sbasami/UAV2024/001_3Dデータ/README.md

# 3Dデータ
* Frame_Prop_4 v5: ロッドフレームの3Dデータ
* Frame_UAV2024 v2: 本体フレームの3Dデータ
