sbasami/UAV2024/000_回路図データ/README.md

# 回路図データ
* BMI088_ver2: BMI088モジュール基板のKiCad回路データ
* UAV2021_ver3: フライトコントローラ基板のKiCad回路データ
* UAV2021_ver3_panelizing: BMI088_ver2とUAV2021_ver3を面付けしたPCBデータとガーバーデータ(このデータを使って基板製造業者に発注)
