sbasami/UAV2024/000_回路図データ/BMI088_ver2/BMI088_2021.xlsx

Designator | Manufacturer Part Number or Seeed SKU | Qty | Link
C1,C2 | GRM155R71C104KA88D | 2 | https://www.digikey.jp/product-detail/ja/murata-electronics/GRM155R71C104KA88D/490-3261-1-ND/702802
IC1 | BMI088 | 1 | https://www.digikey.jp/product-detail/ja/bosch-sensortec/BMI088/828-1082-1-ND/8634942
