sbasami/UAV2024/000_回路図データ/BMI088_ver2/BMI088.step

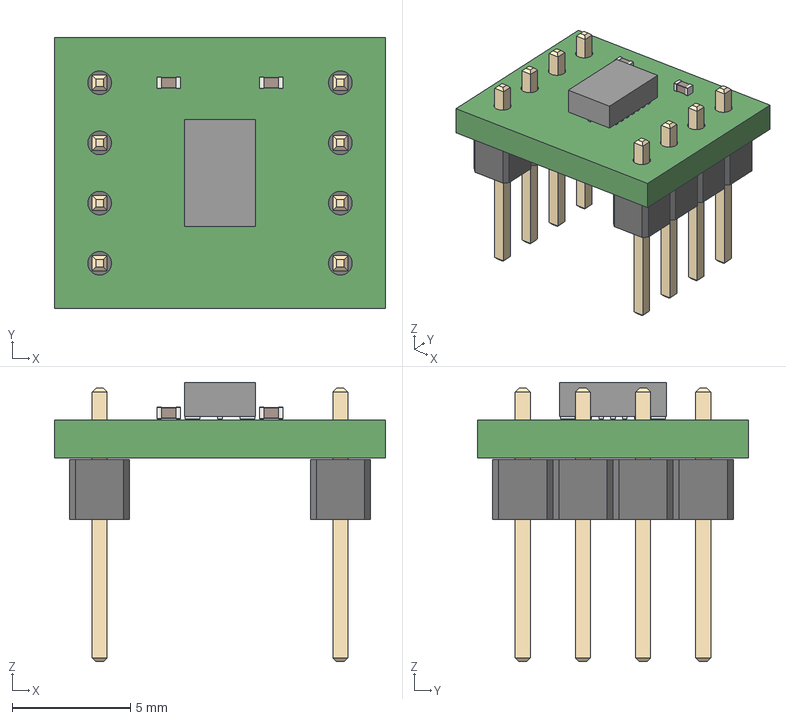
[picture p1: CAD file, 2024-07-15]
000_回路図データ/BMI088_ver2/BMI088.step
14.0 x 11.4 x 11.8 mm
