sbasami/UAV2024/001_3Dデータ/Frame_UAV2024 v2.stl

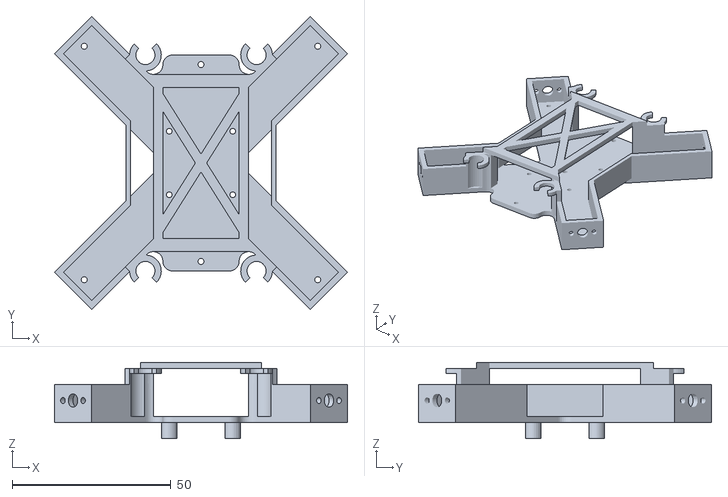
[picture p2: CAD file, 2024-07-21]
001_3Dデータ/Frame_UAV2024 v2.stl
92.3 x 92.3 x 24.0
