sbasami/UAV2024/001_3Dデータ/Frame_Prop_4 v5.stl

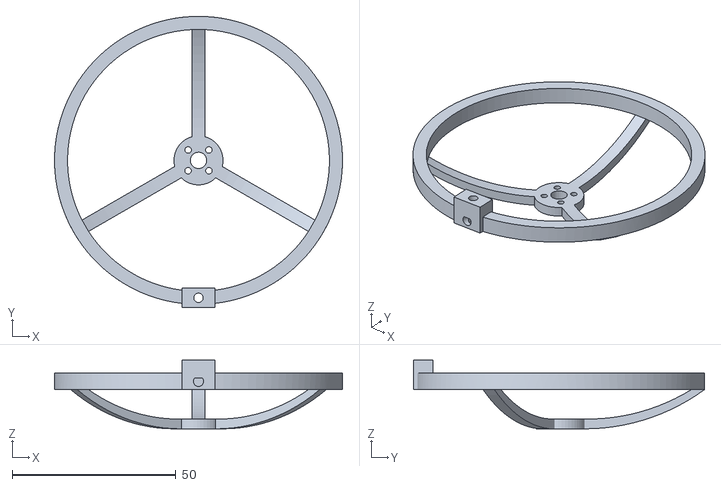
[picture p3: CAD file, 2024-07-21]
001_3Dデータ/Frame_Prop_4 v5.stl
88.0 x 89.0 x 21.0
