sbasami/UAV2024/(list of files, cad)

Other CAD files:
001_3Dデータ/Frame_Prop_4 v5.f3d
001_3Dデータ/Frame_UAV2024 v2.f3d
