sbasami/UAV2024/(list of files, drawings)

Other design files:
000_回路図データ/UAV2021_ver3/UAV2021_ver2.dsn
