sbasami/UAV2024/000_回路図データ/UAV2021_ver3/UAV2021_ver2.kicad_pcb

## KiCad design 000_回路図データ/UAV2021_ver3/UAV2021_ver2.kicad_pcb (2024-07-15)

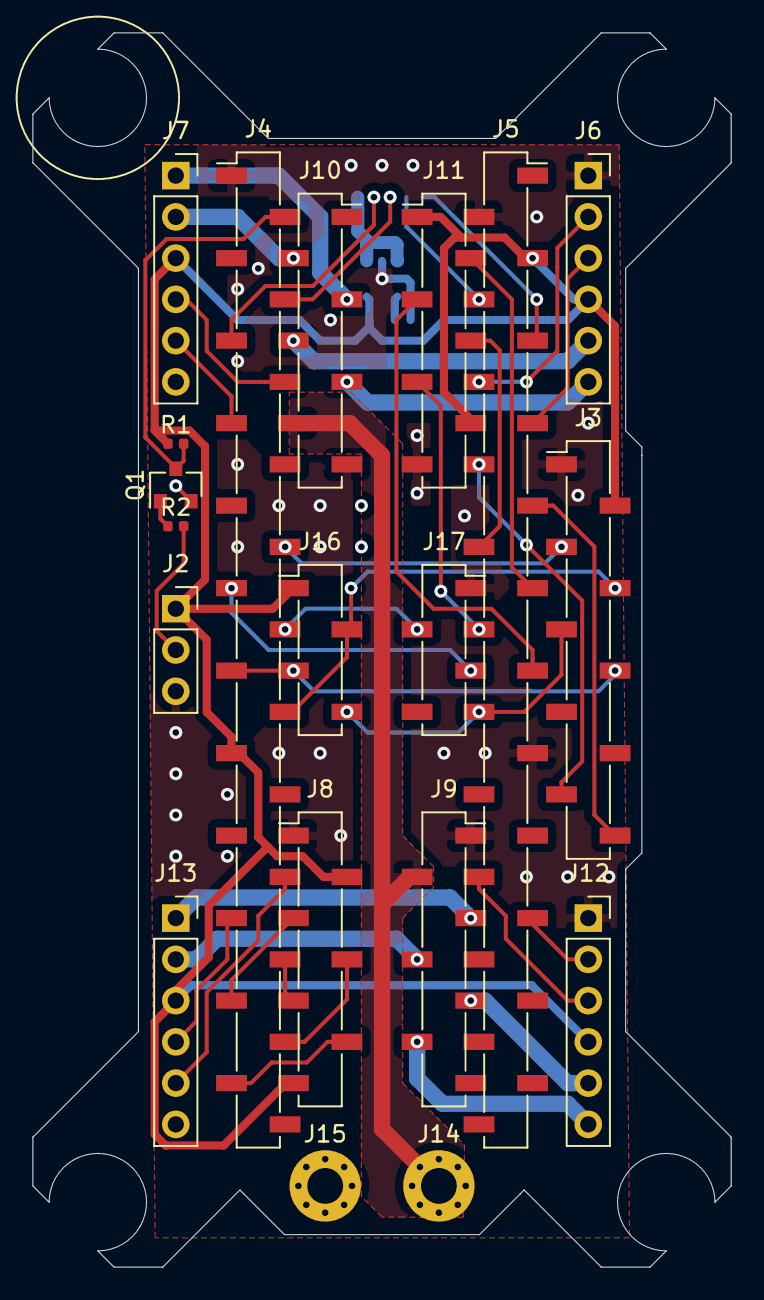
[picture p4: board UAV2021_ver2.kicad_pcb from above]

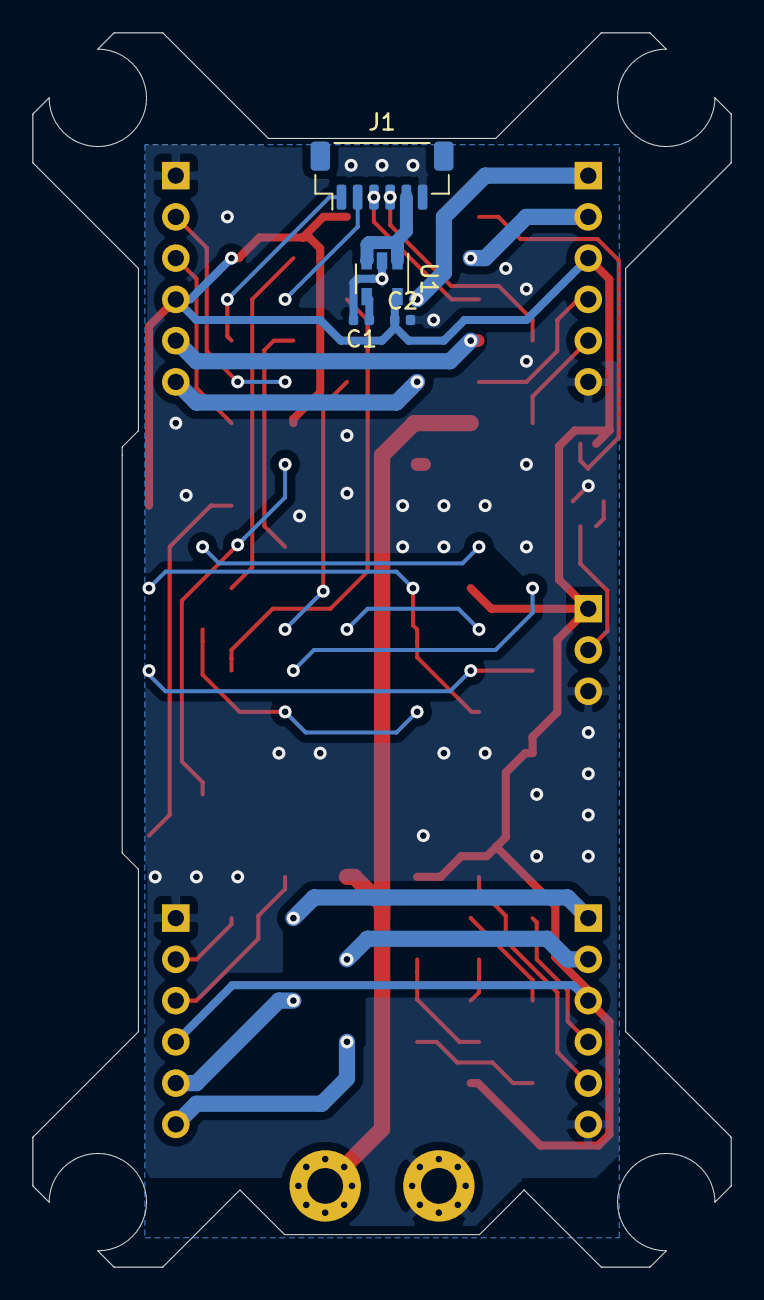
[picture p5: board UAV2021_ver2.kicad_pcb from below]

Board: 2 copper layers, 43.0 x 76.0 mm, 23 parts (4 on the bottom side), 44 nets.

Parts:
C1: 470p; C_0402_1005Metric
C2: 2.2u; C_0402_1005Metric
J1: Conn_01x06; JST_SH_BM06B-SRSS-TB_1x06-1MP_P1.00mm_Vertical
J2: Conn_01x03; PinSocket_1x03_P2.54mm_Vertical
J3: Conn_01x10; PinSocket_1x10_P2.54mm_Vertical_SMD_Pin1Left
J4: Conn_01x24; PinSocket_1x24_P2.54mm_Vertical_SMD_Pin1Left
J5: Conn_01x24; PinSocket_1x24_P2.54mm_Vertical_SMD_Pin1Right
J6, J7, J12, J13: Conn_01x06; PinSocket_1x06_P2.54mm_Vertical
J8, J11: Conn_01x07; PinSocket_1x07_P2.54mm_Vertical_SMD_Pin1Left
J9, J10: Conn_01x07; PinSocket_1x07_P2.54mm_Vertical_SMD_Pin1Right
J14, J15: Conn_01x01; MountingHole_2.2mm_M2_Pad_Via
J16: Conn_01x04; PinSocket_1x04_P2.54mm_Vertical_SMD_Pin1Left
J17: Conn_01x04; PinSocket_1x04_P2.54mm_Vertical_SMD_Pin1Right
Q1: 2N7002K; SOT-23
R1: 10k; R_0402_1005Metric
R2: 3.3k; R_0402_1005Metric
U1: MIC5219-3.3YM5; SOT-23-5

Connections:
+3V3: C2.1, J2.1, J3.2, J4.15, J5.3, J6.4, J7.3, J8.2, J8.7, J11.1, J11.6, J12.4, J13.3, J16.1, R1.1, U1.5
+7.5V: J1.5, U1.1, U1.3
/Sheet60DC4E71/RCV_IN: J2.2, R2.2
AENBL_1: J5.13, J11.3
AENBL_2: J4.20, J8.5
APHAZE_1: J5.11, J11.2
APHAZE_2: J4.23, J8.6
BENBL_1: J5.12, J11.5
BENBL_2: J4.21, J8.3
BPHAZE_1: J5.10, J11.4
BPHAZE_2: J4.22, J8.4
CS_A: J4.12, J17.2
CS_G: J4.11, J17.3
CS_O: J3.3, J4.10
FUTABA: J4.2, Q1.3, R1.2
GND: C1.2, C2.2, J1.6, J2.3, J3.1, J4.1, J5.2, J5.15, J6.1, J7.6, J8.1, J9.1, J10.7, J11.7, J12.1, J13.6, J15.1, J17.1, Q1.2, U1.2
M1_1: J6.6, J10.5
M1_2: J9.6, J12.6
M1_3: J9.3, J13.1
M1_4: J7.1, J10.3
M2_1: J6.5, J10.4
M2_2: J9.5, J12.5
M2_3: J9.4, J13.2
M2_4: J7.2, J10.2
MISO: J3.4, J4.14, J16.2
MOSI: J3.6, J4.13, J16.3
unnamed: C1.1, U1.4
unnamed: Q1.1, R2.1
OUTA_1: J5.7, J6.3
OUTA_2: J5.18, J12.3
OUTA_3: J4.19, J13.4
OUTA_4: J4.6, J7.4
OUTB_1: J5.6, J6.2
OUTB_2: J5.19, J12.2
OUTB_3: J4.18, J13.5
OUTB_4: J4.7, J7.5
PWM_1: J1.1, J5.5
PWM_2: J1.2, J5.4
PWM_3: J1.3, J4.4
PWM_4: J1.4, J4.5
SCK: J3.5, J5.14, J16.4
SCL: J3.9, J5.8
SDA: J3.10, J5.9
VCC: J9.2, J10.6, J14.1
