sbasami/UAV2024/000_回路図データ/BMI088_ver2/BMI088.kicad_pcb

## KiCad design 000_回路図データ/BMI088_ver2/BMI088.kicad_pcb (2024-07-15)

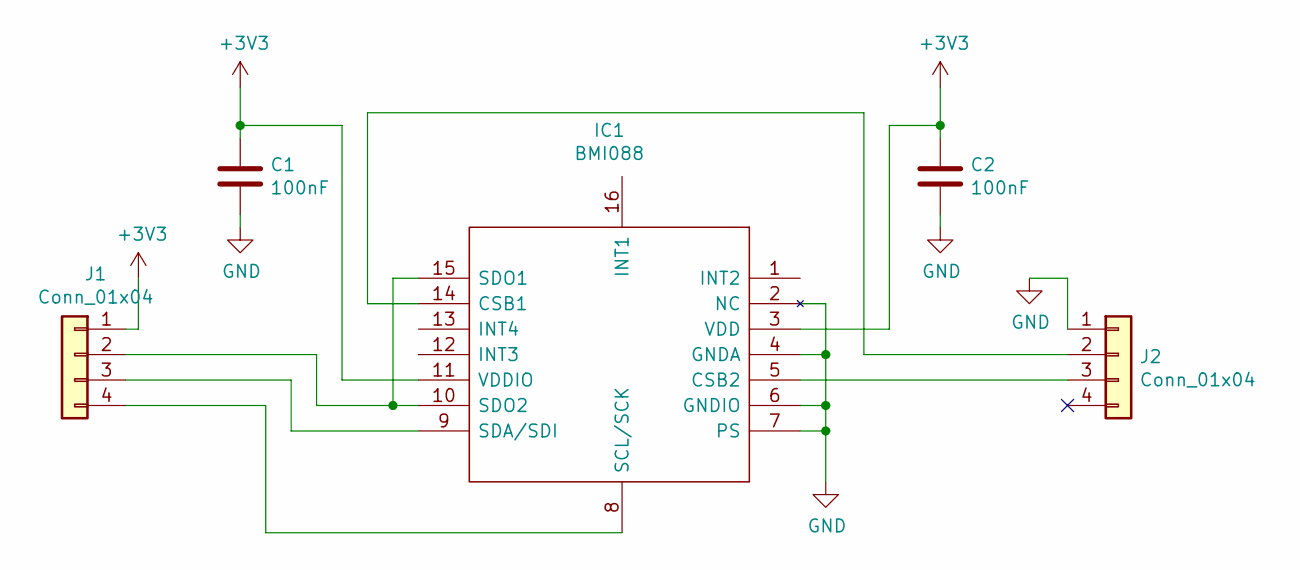
[picture p6: schematic BMI088.sch]

Parts:
C1, C2: 100nF; C_0402_1005Metric
IC1: BMI088; Manufacturer_Part_Number BMI088
J1, J2: Conn_01x04; PinHeader_1x04_P2.54mm_Vertical

Connections:
+3V3: C1.1, C2.1, IC1.3 (VDD), IC1.11 (VDDIO), J1.1
GND: C1.2, C2.2, IC1.2 (NC), IC1.4 (GNDA), IC1.6 (GNDIO), IC1.7 (PS), J2.1
unnamed: IC1.5 (CSB2), J2.3
unnamed: IC1.8 (SCL/SCK), J1.4
unnamed: IC1.9 (SDA/SDI), J1.3
unnamed: IC1.10 (SDO2), IC1.15 (SDO1), J1.2
unnamed: IC1.14 (CSB1), J2.2

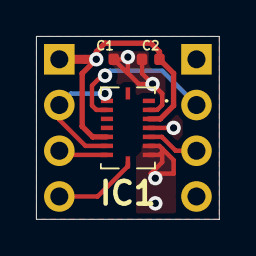
[picture p7: board BMI088.kicad_pcb from above]

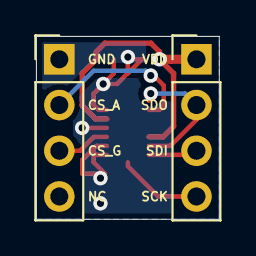
[picture p8: board BMI088.kicad_pcb from below]

Board: 2 copper layers, 10.2 x 10.2 mm, 5 parts (2 on the bottom side), 7 nets.
