sbasami/UAV2024/(commit log)

2024-07-15 回路図データを追加
    追加したデータがそれぞれ何なのかは000_回路図データフォルダ内のREADME.mdを参照
    [BMI088.kicad_pcb, BMI088.sch, BMI088.step, BMI088_2021.xlsx, DRV8836.sch, FUTABA_Receiver.sch, MIC5219-3.3YM5.sch, UAV2021_ver2.dsn]
2024-07-21 3Dデータを追加
    [Frame_Prop_4 v5.f3d, Frame_Prop_4 v5.stl, Frame_UAV2024 v2.f3d, Frame_UAV2024 v2.stl]
2024-08-17 PlatformIOでTeensy4.1用のプロジェクトを作成
2024-08-17 Clang-formatの追加
2024-08-17 Cppcheckで静的解析を実施する設定を追加
    Platform IOはデフォルトで暗黙的にCppcheckで静的解析を実施するようになっているが明示的に設定
    詳細は下記参照
    https://docs.platformio.org/en/latest//advanced/static-code-analysis/tools/cppcheck.html
2024-08-25 Clang-formatルール更新、Clang Format Editorにアップロードする用のファイル(clamg-format)追加
2024-08-26 SbusReceiverクラス追加
    Sbusで受信したデータを0~1の範囲のデータに変換して提供する
2024-08-27 cppcheckの指摘修正
    Class 'SbusReceiver' has a constructor with 1 argument that is not explicit.
    [SbusReceiver.h]
2024-08-27 ビルドエラーになったので変数名変更
2024-08-27 不要な定義削除、defineをconstexprに変更
2024-08-30 ServoEncoderクラス追加
    エンコーダで取得した値をdeg or radの単位で提供する
2024-08-31 ServoDriverクラス追加
    Dutyを-1~1の範囲で設定しPWM出力する
2024-08-31 ServoControllerクラス追加
    目標角度[rad]、現在角度[rad]、電源電圧[V]からDuty[-1~1]を計算する
2024-08-31 Servo関係の処理をservo.cppに集約
2024-09-01 cppcheckの指摘修正
2024-09-21 AttitudeSensorクラス追加
    センサ情報から機体の姿勢を計算するクラス
2024-09-22 ThrustDriverクラス、ThrustControllerクラス追加、Thrust関係の処理をthrust.cppに集約
    ThrustDriverクラス：Dutyを0~1の範囲で設定しPWM出力する
    ThrustControllerクラス：推力[N]をDuty[0-1]に変換する(現状は入力値を0-1で制限する機能のみ)
2024-11-04 ServoDriverに回転方向を変更する機能を追加
    回路的に1つだけモータの接続が反転しているため4つのモータに同じ信号を送った時に1つだけ反対方向に回転していた。
    ハードの差を吸収できるようにソフト的に回転方向を指定できる機能を追加。
2024-12-01 AttitudeControllerクラス
    目標姿勢と現在姿勢の回転行列から誤差回転行列を計算し、PID制御の制御量を計算する
2024-12-01 AttitudePlannerクラス追加
    プロポの信号と現在姿勢から目標姿勢を計算する
2024-12-01 PositionControllerクラス追加
    位置の制御量を計算する
2024-12-01 Distributorクラス
    位置と姿勢の操作量をモータ推力とサーボ角度に変換する
2024-12-01 ドローン制御関係の処理をdrone.cppに集約
2024-12-01 main.cをドローン制御用に変更(この時点で一応飛行できる)
2024-12-01 Yaw軸Pゲインを調整
2024-12-14 位置の制御量を座標変換する機能を追加
    姿勢が傾いても操作感覚が変わらないように位置の制御量を姿勢で座標変換
2025-02-11 目標姿勢をランプ上に変化させる機能を追加
2025-02-11 加速度センサの初期化失敗の対策
2025-02-11 プロポのY軸制御の座標系が間違っていたので修正
    プロポの操作に対する操作量の変化の方向が変わったのでプログラム側も修正
2025-02-12 チルト飛行に関連するパラメータのIF関数追加
2025-02-15 コメント追加変更
